mqce/supermini-lipo-motor/fabrication/bom.csv

Comment | Designator | Footprint | LCSC Part #
TC118S | U1,U2 | SOP-8 | C88308
TP4056 | U3 | ESOP-8 | C382139
B5819W | D1 | SOD-123 | C8598
KT-0603R | LED1 | LED0603 | C2286
0603WAF1002T5E | R1 | R0603 | C25804
0402WGF1001TCE | R2 | R0402 | C11702
0402WGF1000TCE | R3,R4,R5,R6 | R0402 | C25076
10uF 10V | C1,C2,C3,C5 | C0603 | C19702
100nF 16V | C4,C6,C7,C8 | C0402 | C1525
22uF 25V | C9 | C0805 | C45783
