mqce/supermini-lipo-motor/production/bom.csv

Designator | Footprint | Quantity | Value | LCSC Part #
C1, C2, C3, C5 | 0603 | 4 | 10uF
C4, C6, C7, C8 | 0402 | 4 | 100nF
C9 | 0805 | 1 | 22uF
D1 | D_SOD-123 | 1 | B5819W
LED1 | 0603 | 1 | RED
R1 | 0603 | 1 | 10k
R2 | 0402 | 1 | 1k
R3, R4, R5, R6 | 0402 | 4 | 100
U1, U2 | SOIC-8_3.9x4.9mm_P1.27mm | 2 | TC118S
U3 | SOIC-8-1EP_3.9x4.9mm_P1.27mm_EP2.41x3.3mm | 1 | TP4056
