mqce/supermini-lipo-motor/supermini-lipo-motor.kicad_pcb

## KiCad design supermini-lipo-motor.kicad_pcb (2026-11-02)

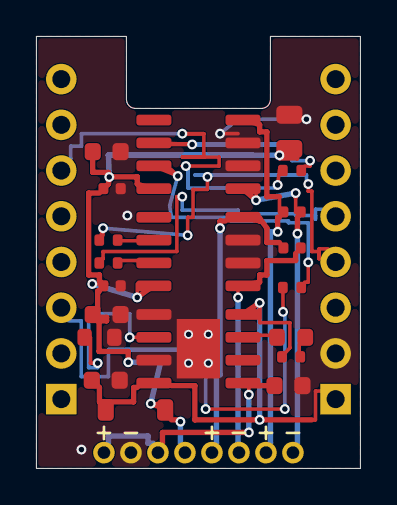
[picture p1: board supermini-lipo-motor.kicad_pcb from above]

Board: 2 copper layers, 18.0 x 24.0 mm, 23 parts (0 on the bottom side), 19 nets.

Parts:
C1, C2, C3, C5: 10uF; C_0603_1608Metric
C4, C6, C7, C8: 100nF; C_0402_1005Metric
C9: 22uF; C_0805_2012Metric
D1: B5819W; D_SOD-123
J1: ESP_L; PTH_1x08_P2.54mm
J2: ESP_R; PTH_1x08_P2.54mm
J3: WIRES
LED1: RED; LED_0603_1608Metric
R1: 10k; R_0603_1608Metric
R2: 1k; R_0402_1005Metric
R3, R4, R5, R6: 100; R_0402_1005Metric
U1, U2: TC118S; SOIC-8_3.9x4.9mm_P1.27mm
U3: TP4056; SOIC-8-1EP_3.9x4.9mm_P1.27mm_EP2.41x3.3mm

Connections:
CHRG: LED1.1, U3.7
GND: C1.2, C2.2, C3.2, C4.2, C5.2, C6.2, C9.2, J1.2, J3.2, R1.2, U1.6, U1.7, U2.6, U2.7, U3.1, U3.3, U3.9
GPIO3: J1.5, R4.1
GPIO4: J1.4, R3.1
GPIO7: J2.3, R6.1
GPIO10: J2.6, R5.1
LED_A: LED1.2, R2.2
M1+: C7.1, J3.5, U1.8
M1-: C7.2, J3.6, U1.5
M1_INA: R3.2, U1.2
M1_INB: R4.2, U1.3
M2+: C8.1, J3.7, U2.8
M2-: C8.2, J3.8, U2.5
M2_INA: R5.2, U2.2
M2_INB: R6.2, U2.3
PROG: R1.1, U3.2
V5: C1.1, D1.1, J1.1, R2.1, U3.4, U3.8
VBAT: C2.1, J3.1, J3.3, U3.5
VSW: C3.1, C4.1, C5.1, C6.1, C9.1, D1.2, J3.4, U1.4, U2.4
